SimonAulet/Analisis-Wilkinson/Gerber/Pdf A4 puro.pdf

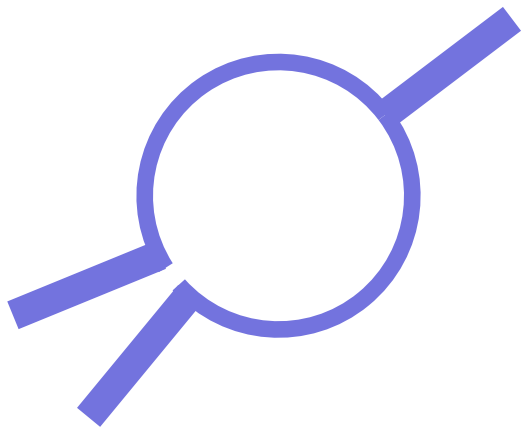
[picture p13: figure]
