SimonAulet/Analisis-Wilkinson/imagenes/Img simulado.pdf

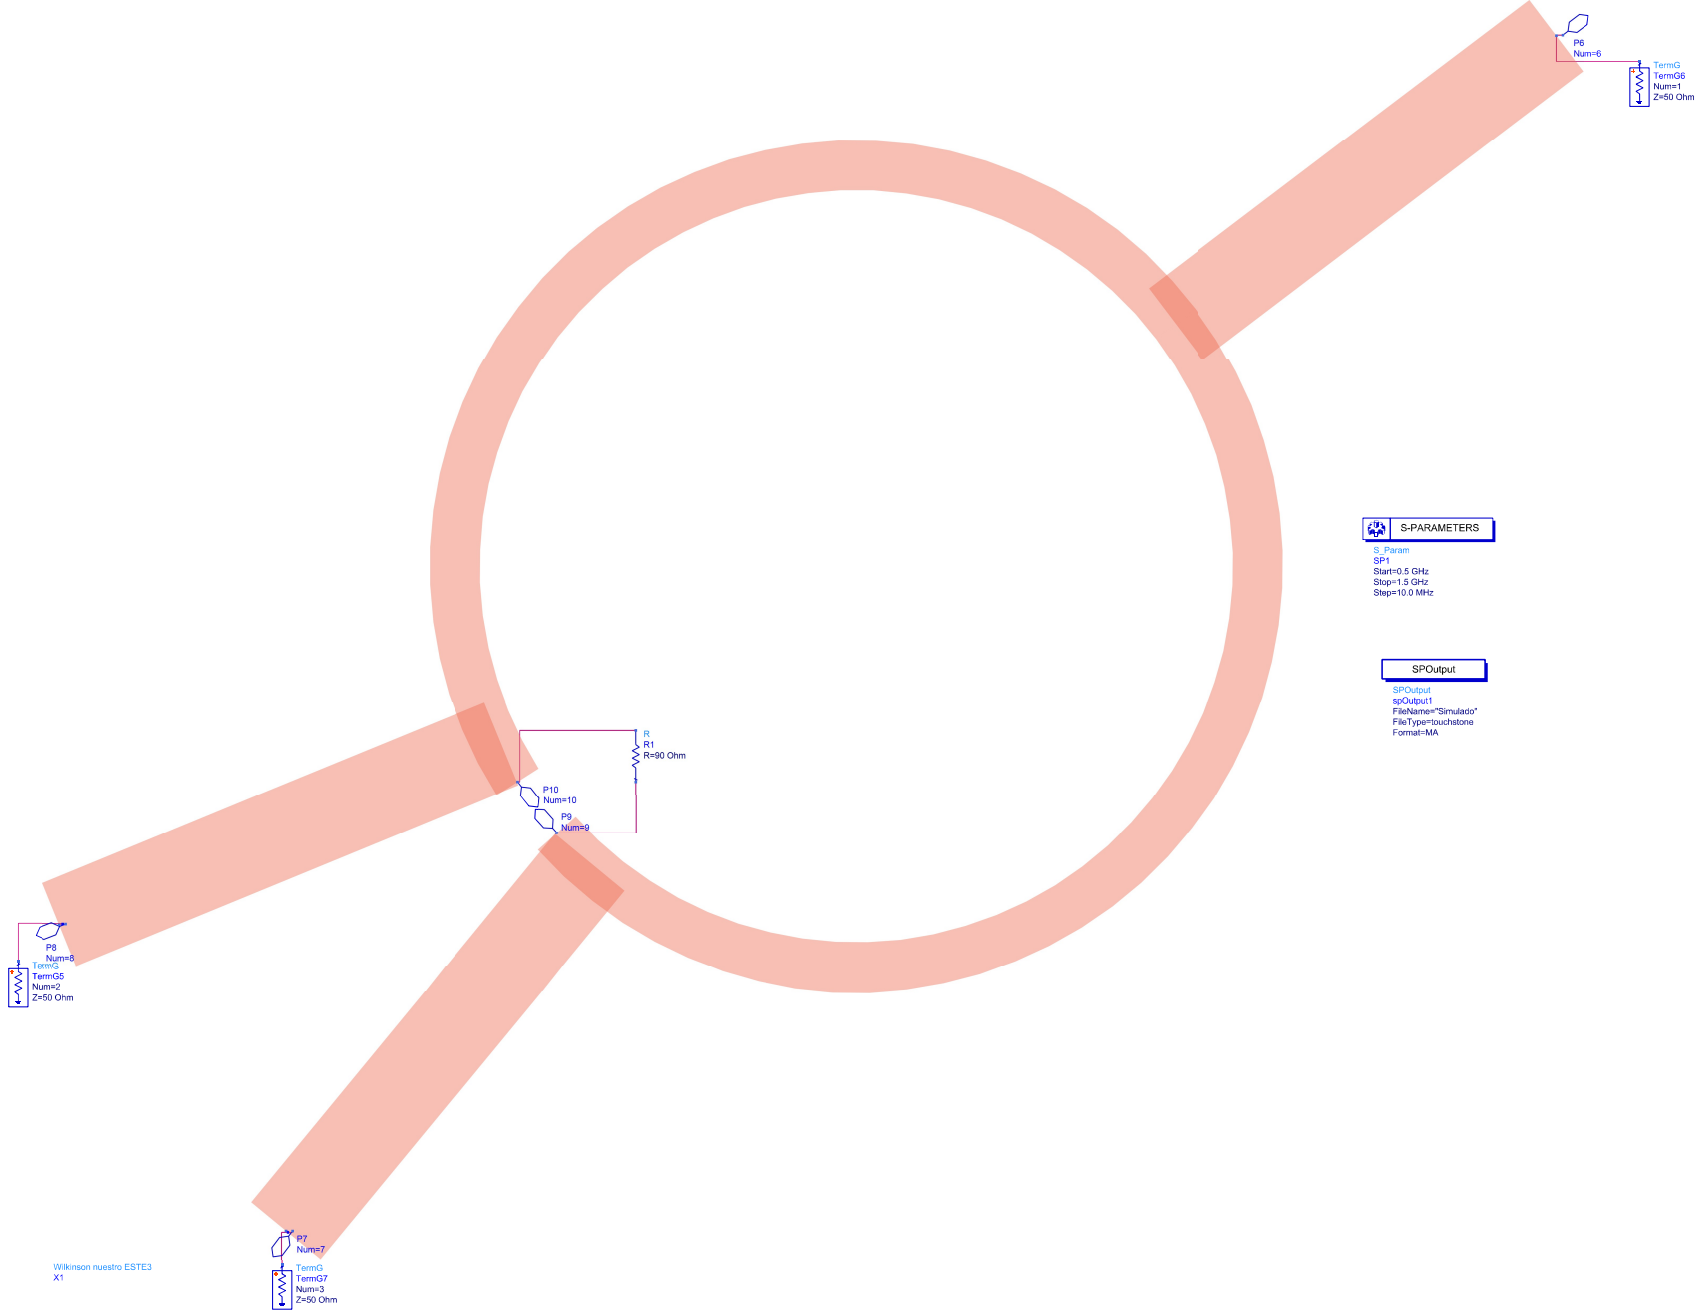
[picture p14: page 1]
