SimonAulet/Analisis-Wilkinson/Gerber/gerber.png

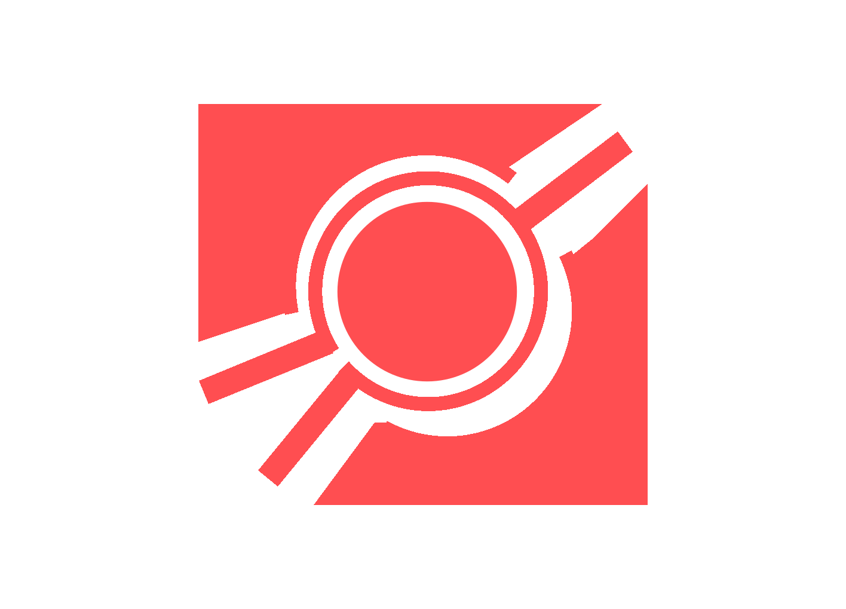
Gerber/gerber.png
