SimonAulet/Analisis-Wilkinson/imagenes/20250618_173053.jpg

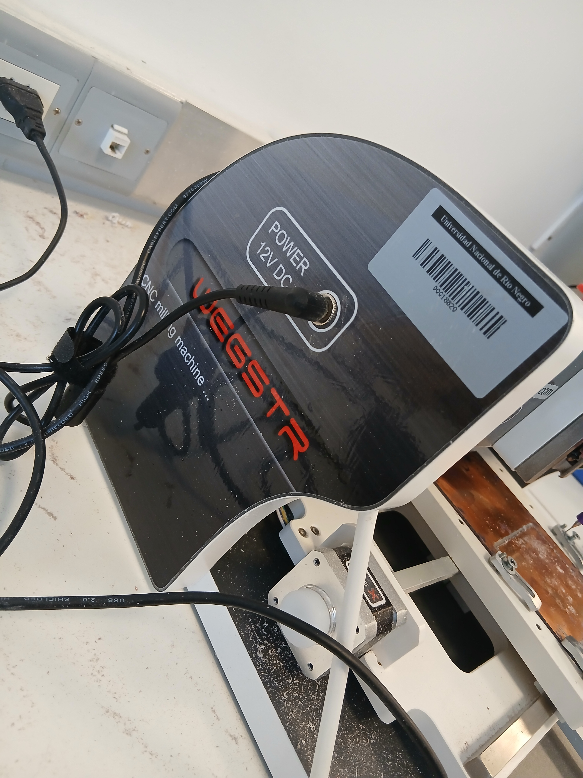
imagenes/20250618_173053.jpg
