SimonAulet/Analisis-Wilkinson/imagenes/Dia mediciones/1 con 2/WhatsApp Image 2025-06-24 at 21.22.09.jpeg

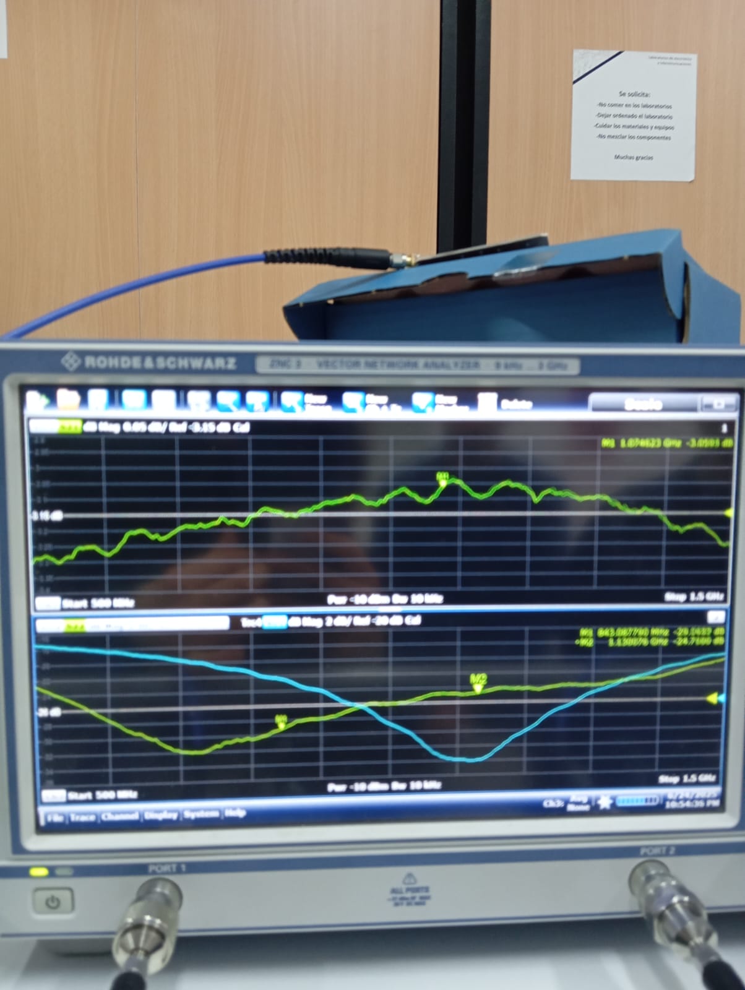
imagenes/Dia mediciones/1 con 2/WhatsApp Image 2025-06-24 at 21.22.09.jpeg
