SimonAulet/Analisis-Wilkinson/imagenes/Dia mediciones/1 con 3/WhatsApp Image 2025-06-24 at 21.22.40 (2).jpeg

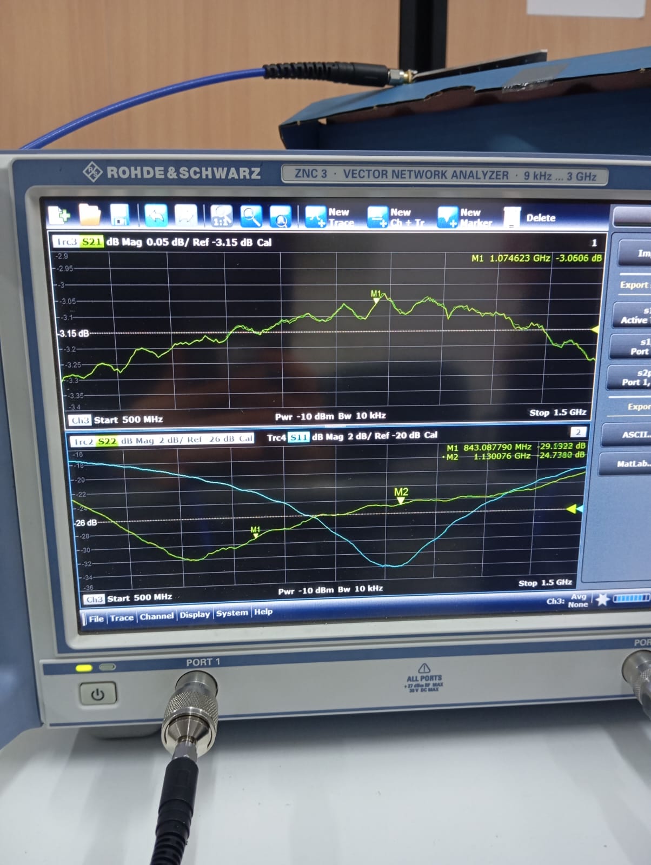
imagenes/Dia mediciones/1 con 3/WhatsApp Image 2025-06-24 at 21.22.40 (2).jpeg
