SimonAulet/Analisis-Wilkinson/imagenes/Dia mediciones/2 con 3/WhatsApp Image 2025-06-24 at 21.21.33.jpeg

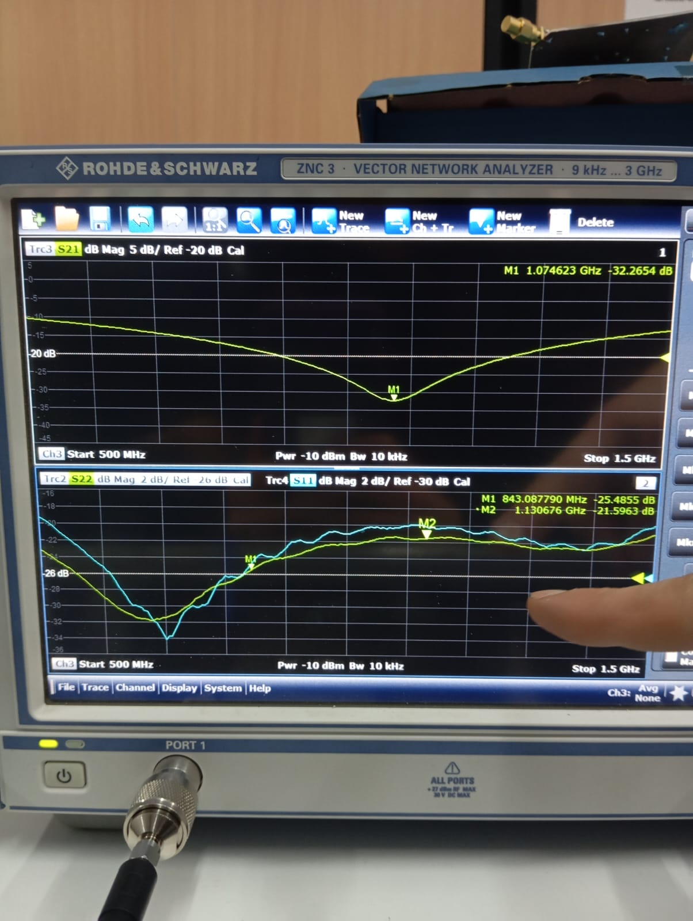
imagenes/Dia mediciones/2 con 3/WhatsApp Image 2025-06-24 at 21.21.33.jpeg
