SimonAulet/Analisis-Wilkinson/imagenes/Dia mediciones/Cables/WhatsApp Image 2025-06-24 at 21.23.09 (1).jpeg

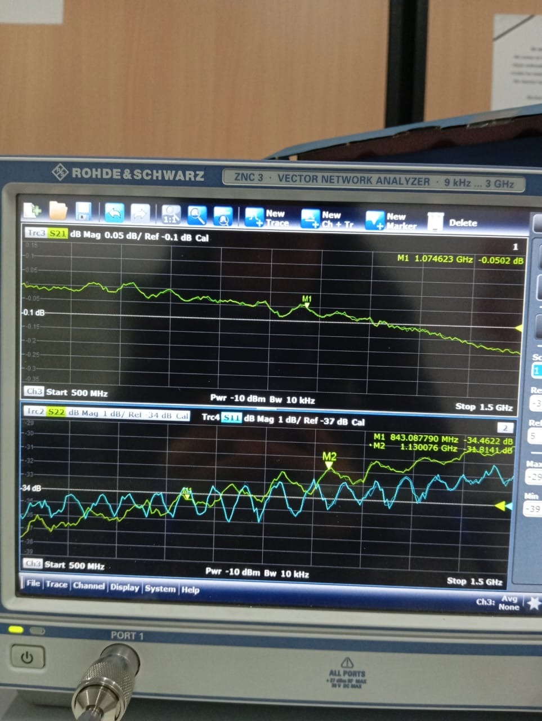
imagenes/Dia mediciones/Cables/WhatsApp Image 2025-06-24 at 21.23.09 (1).jpeg
