SimonAulet/Analisis-Wilkinson/imagenes/IMG-20250618-WA0000.jpg

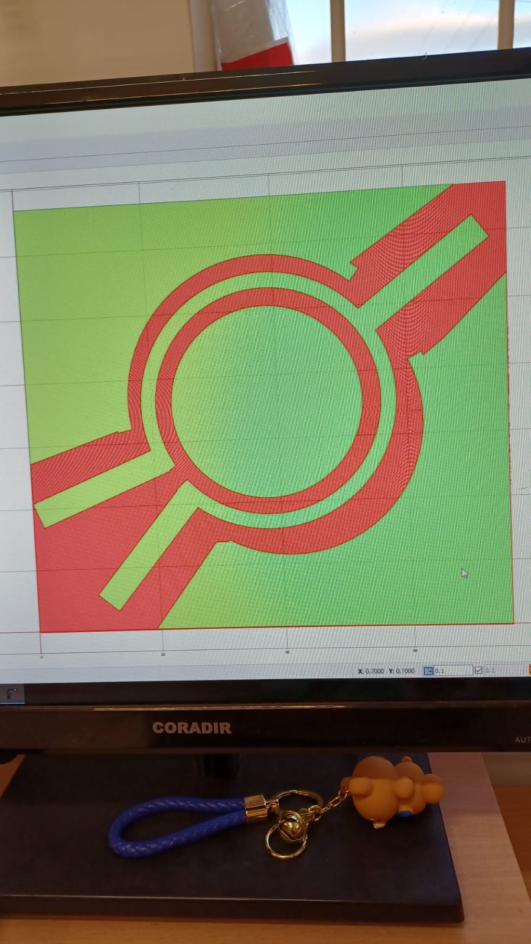
imagenes/IMG-20250618-WA0000.jpg
