SimonAulet/Analisis-Wilkinson/imagenes/IMG-20250618-WA0004.jpg

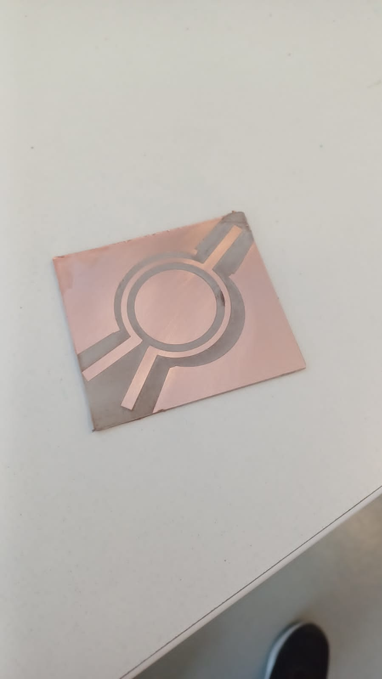
imagenes/IMG-20250618-WA0004.jpg
