SimonAulet/Analisis-Wilkinson/imagenes/IMG-20250618-WA0012.jpg

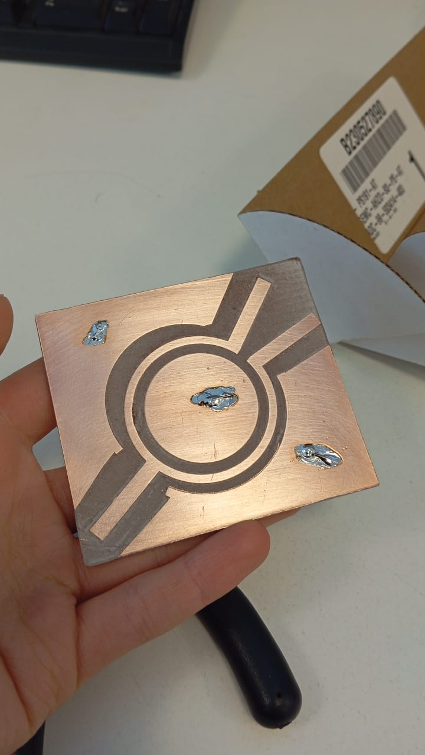
imagenes/IMG-20250618-WA0012.jpg
