SimonAulet/Analisis-Wilkinson/informe/img/datasheet_wegstr.png

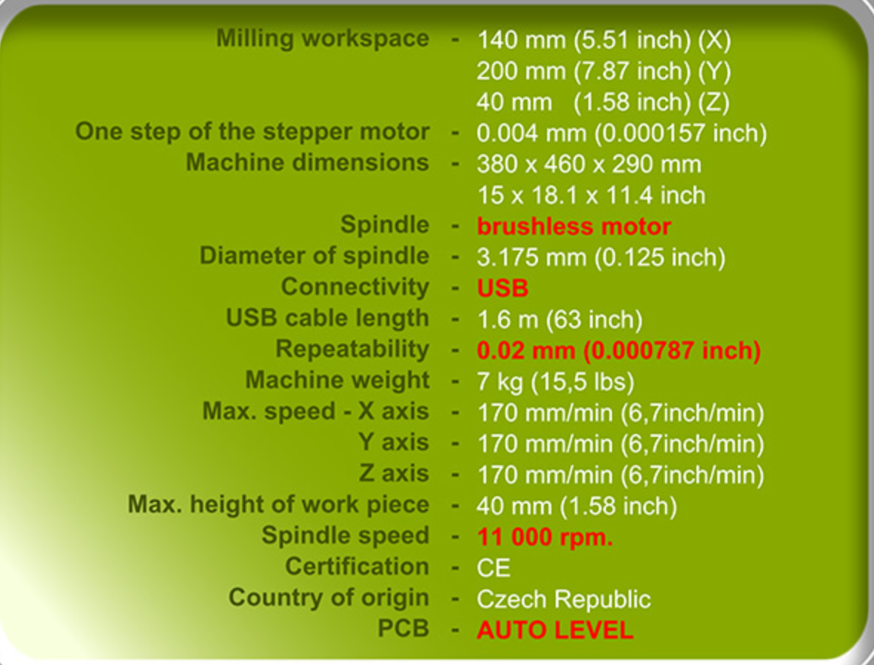
informe/img/datasheet_wegstr.png
