SimonAulet/Analisis-Wilkinson/sustratos/IMG_20250603_183718.jpg

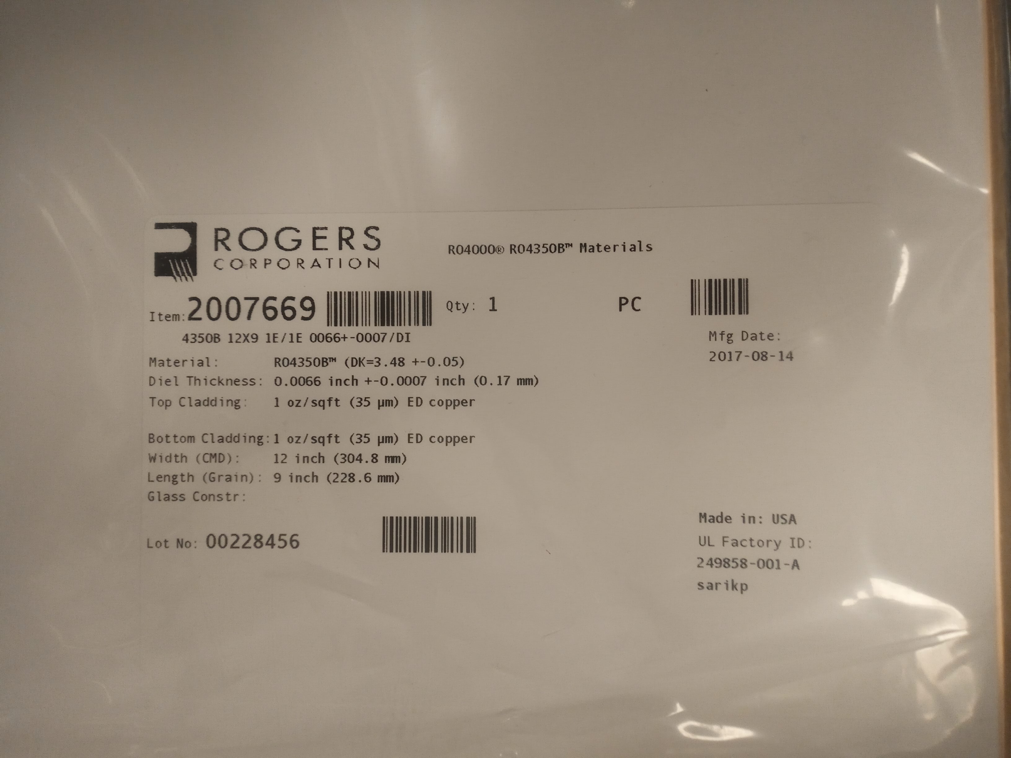
sustratos/IMG_20250603_183718.jpg
