SimonAulet/Analisis-Wilkinson/sustratos/IMG_20250603_183737.jpg

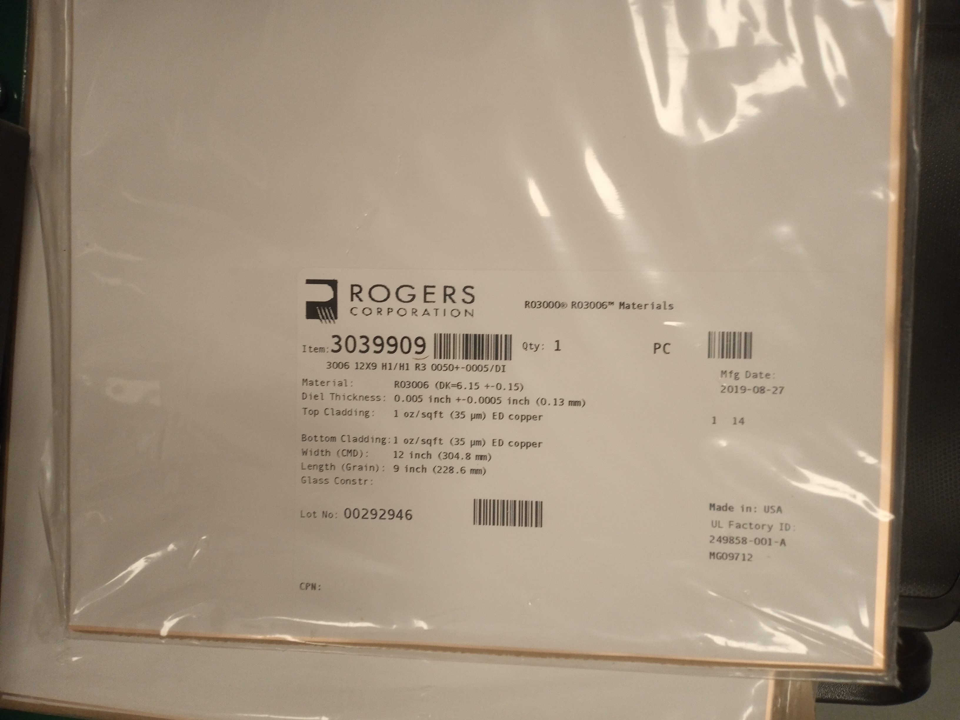
sustratos/IMG_20250603_183737.jpg
