SimonAulet/Analisis-Wilkinson/sustratos/IMG_20250603_183801.jpg

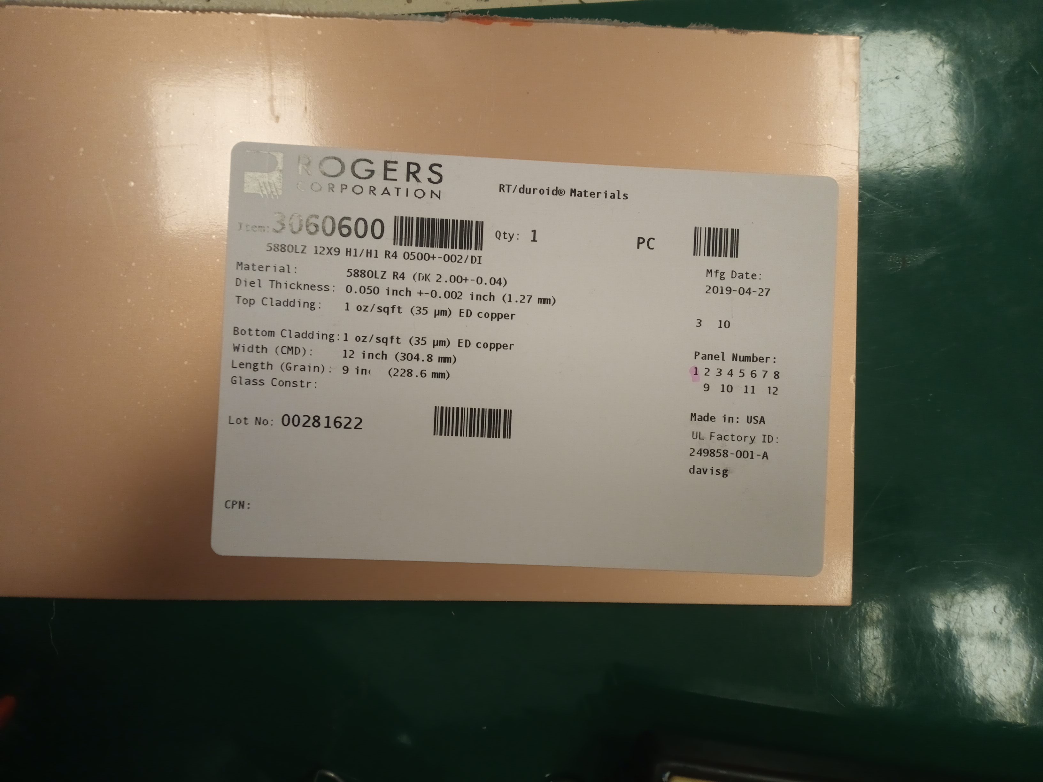
sustratos/IMG_20250603_183801.jpg
