SimonAulet/Analisis-Wilkinson/Gerber/print desde ADS.pdf

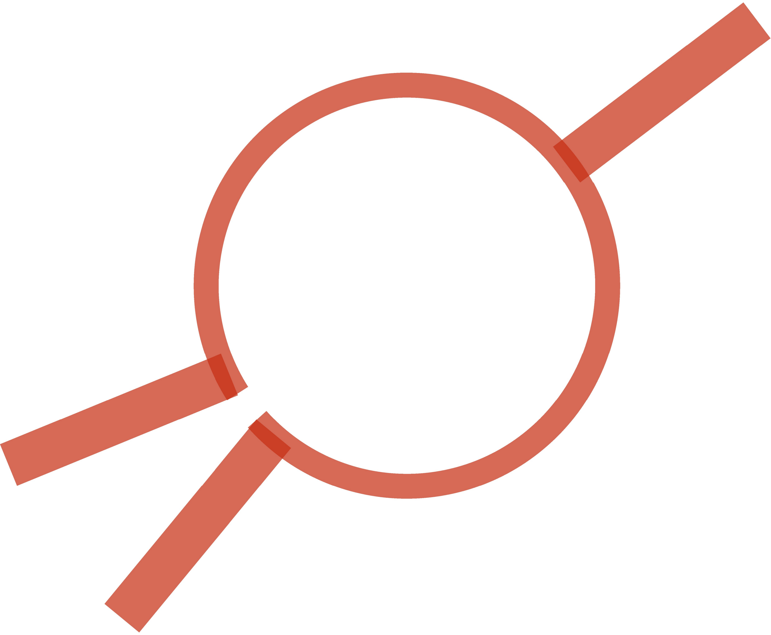
[picture p35: figure]
