SimonAulet/Analisis-Wilkinson/Gerber/Este.pdf

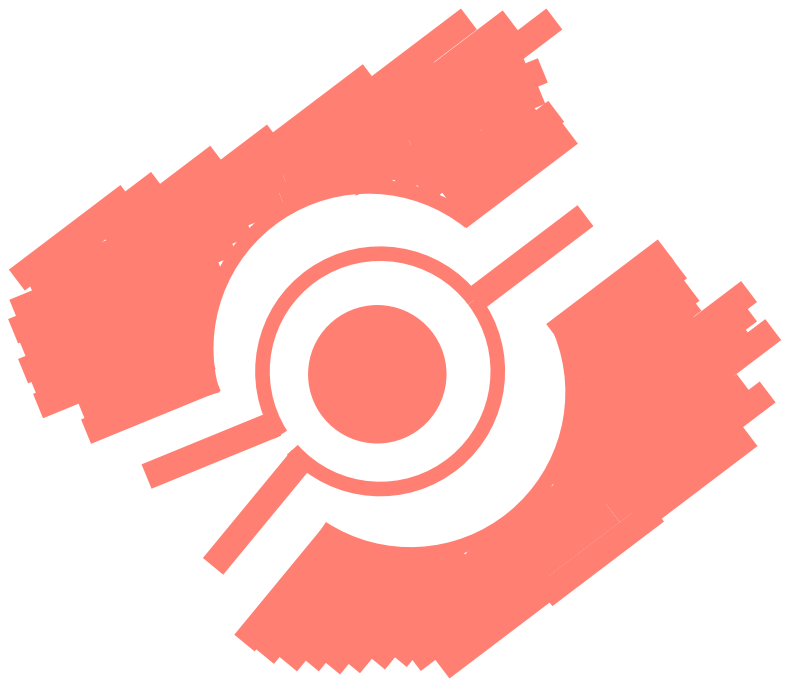
[picture p36: page 1]
