SimonAulet/Analisis-Wilkinson/Gerber/Pdf A4 con relleno invertido.pdf

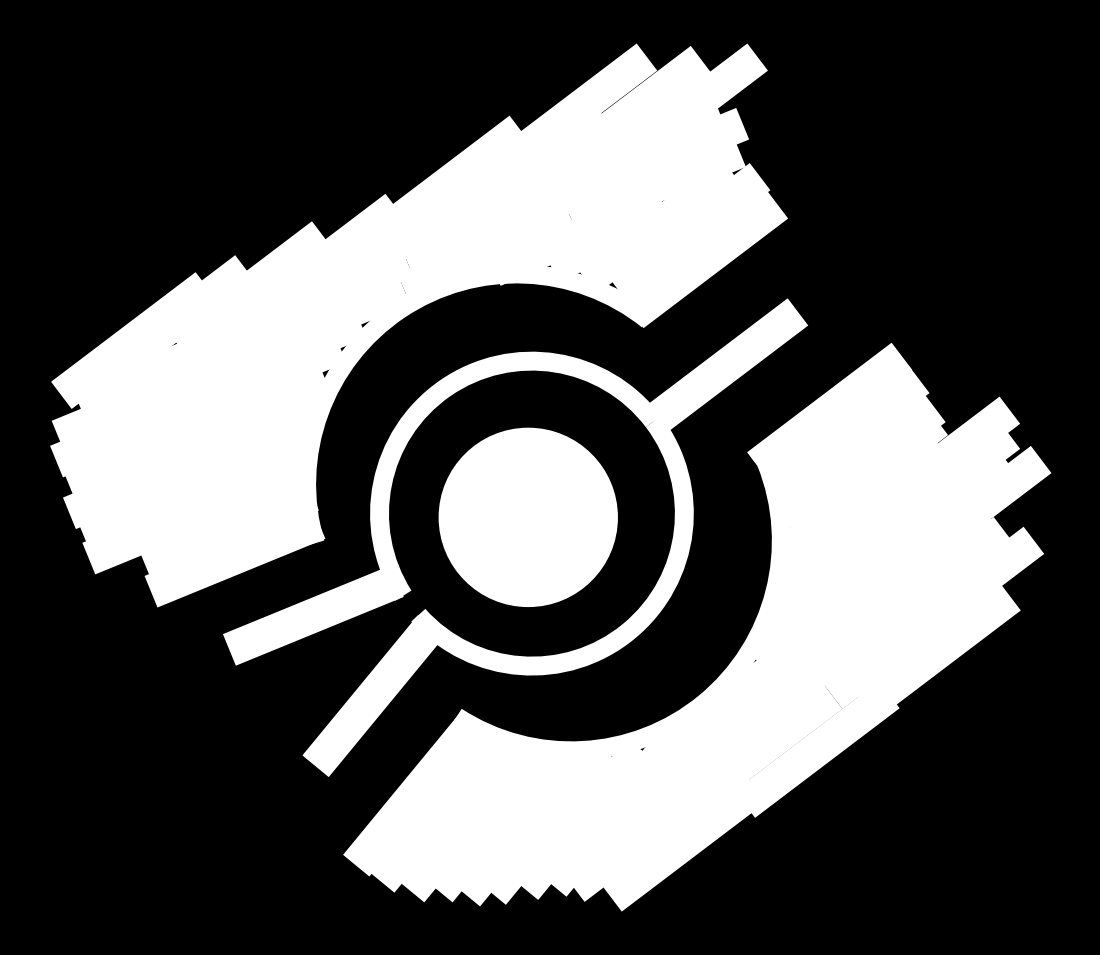
[picture p37: page 1]
