SimonAulet/Analisis-Wilkinson/Gerber/Pdf A4 con relleno.pdf

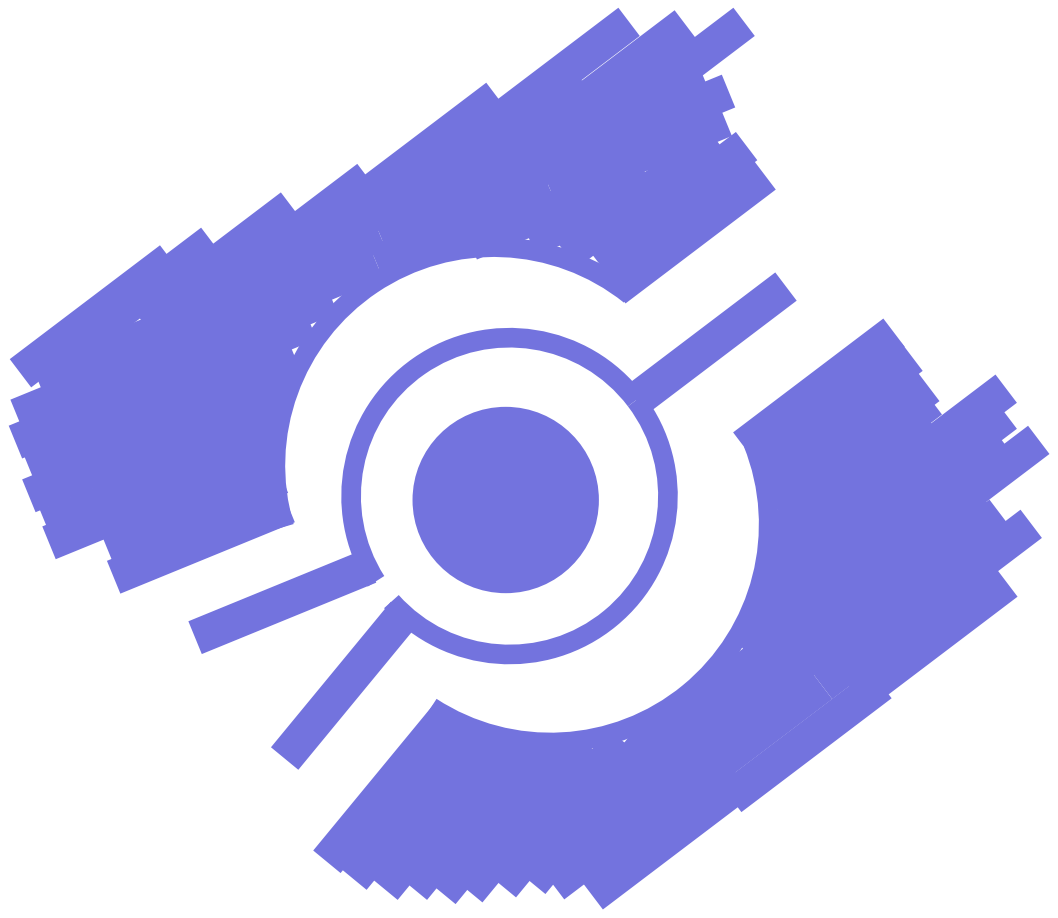
[picture p38: page 1]
