SimonAulet/Analisis-Wilkinson/imagenes/img ideal.pdf

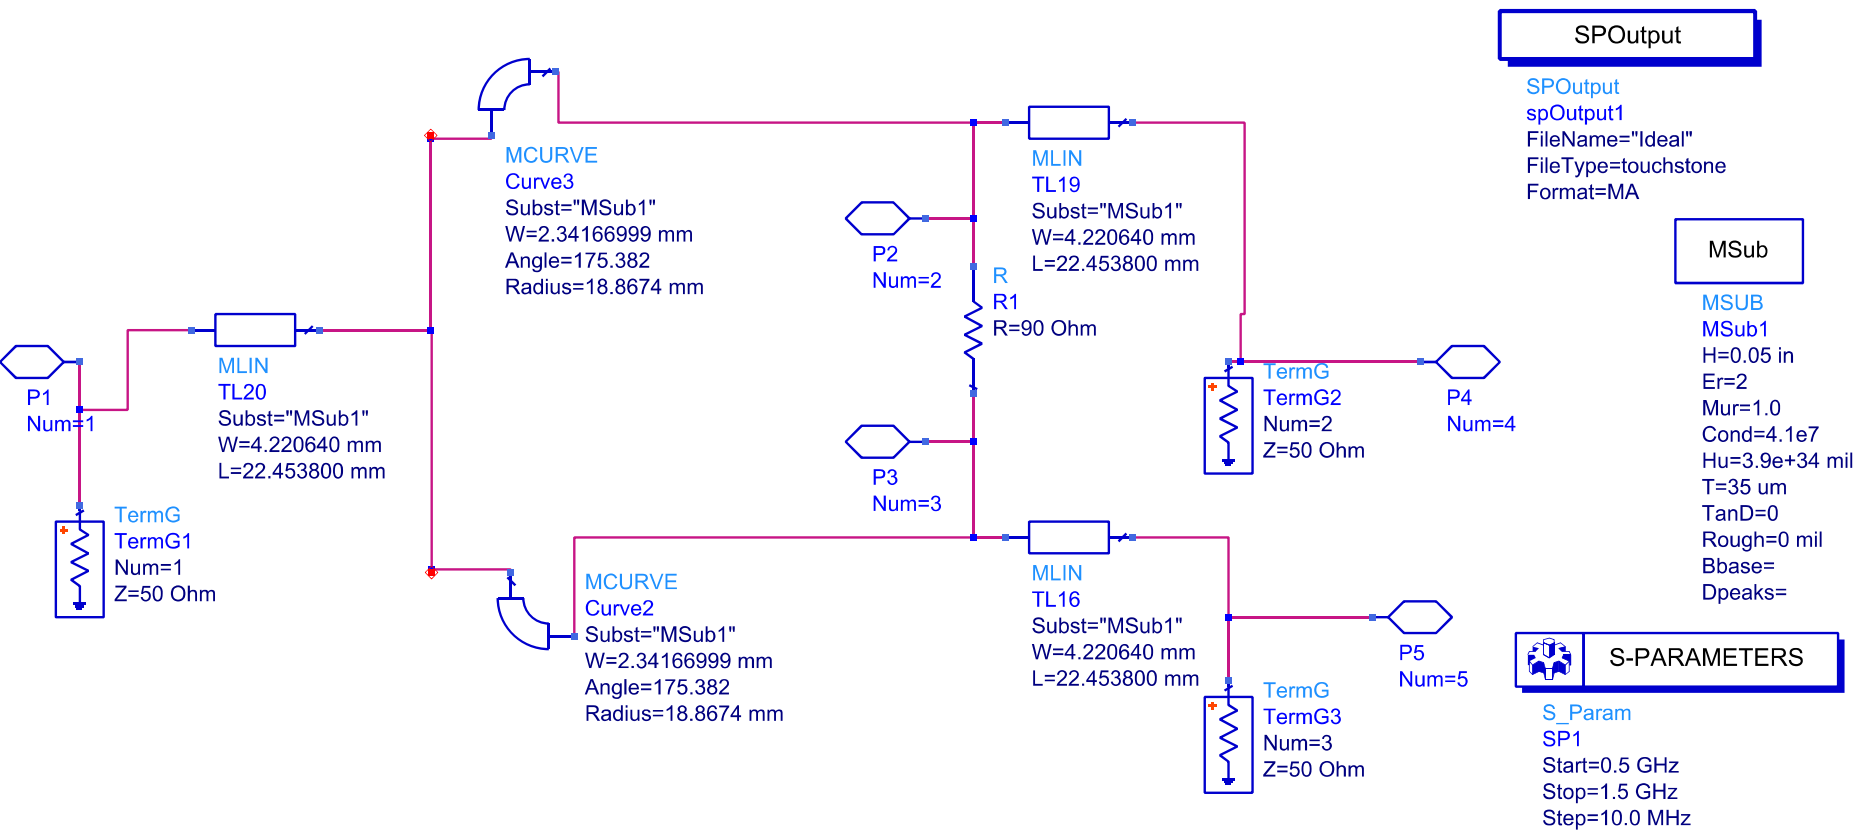
[picture p39: page 1]
