SimonAulet/Analisis-Wilkinson/simulaciones/archivado/Simulacion con bloque simulado en 3D.pdf

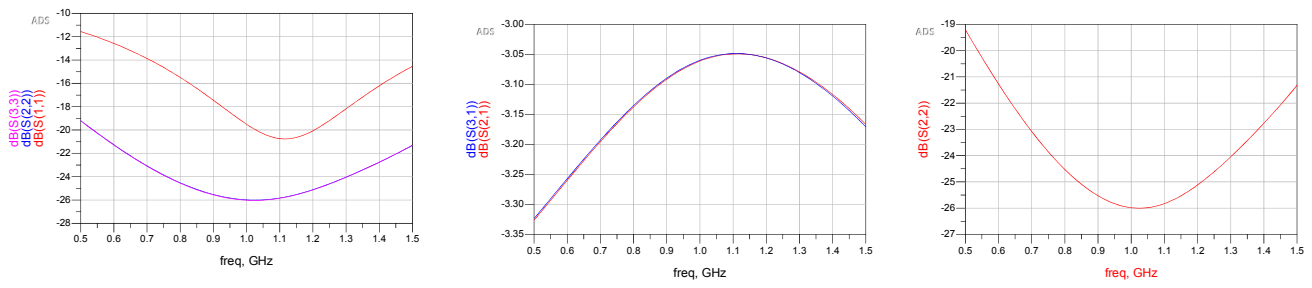
[picture p40: page 1]

freq, GHz dB⁽S⁽³,1⁾⁾ dB⁽S⁽²,1⁾⁾

freq, GHz dB⁽S⁽³,3⁾⁾ dB⁽S⁽²,2⁾⁾ dB⁽S⁽¹,1⁾⁾

freq, GHz dB⁽S⁽²,2⁾⁾
