SimonAulet/Analisis-Wilkinson/(commit log)

2025-07-26 sumo funcion para ploteos
2025-07-26 Aislo funcion de ploteo y la mejoro
