SimonAulet/Analisis-Wilkinson/imagenes/20250624_153320.jpg

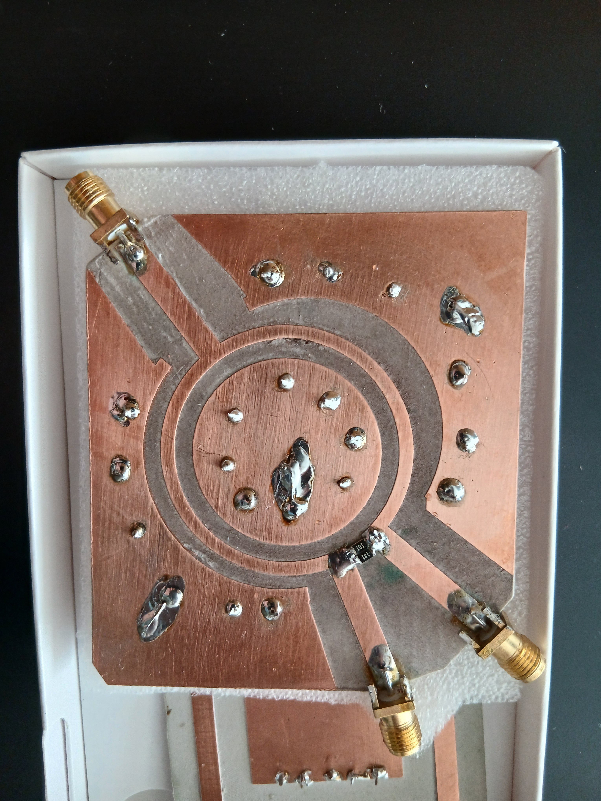
imagenes/20250624_153320.jpg
